tart-telescope/radio_module/README.md

# radio_module
Code for the TART-3 radio module (verilog for the FPGA, C for the microcontroller)
