tart-telescope/radio_module/hardware/README.md

# Hardware PCB designs and Schematics

This folder contains the schematics for the radio module of the TART radio telescope.

Author: Tim Molteno tim@elec.ac.nz
