tart-telescope/radio_module/hardware/papilio_sodimm_interposer/README.md

Relies on the github libraries for DDR3

https://github.com/ganioc/kicad-footprint/
