tart-telescope/radio_module/hardware/papilio_sodimm_interposer/spartan-6_papilio_sodimm.ods

Device/Package 6slx9tqg144 Wed Mar 31 17 | 26 | 10 2010
Pin | Bank | BUFIO2 | Pin Description | SODIMM 204 Pin | Papilio Pro + | Pin# Papilio Pro + | TART assignment
P144 | 0 | TL | IO_L1P_HSWAPEN_0 |  | GND | PWR
P143 | 0 | TL | IO_L1N_VREF_0 |  | BA0 | MEM
P142 | 0 | TL | IO_L2P_0 |  | BA1 | MEM
P141 | 0 | TL | IO_L2N_0 |  | A10 | MEM
P140 | 0 | TL | IO_L3P_0 |  | A0 | MEM
P139 | 0 | TL | IO_L3N_0 |  | A1 | MEM
P138 | 0 | TL | IO_L4P_0 |  | A2 | MEM
P137 | 0 | TL | IO_L4N_0 |  | A3 | MEM
P134 | 0 | TL | IO_L34P_GCLK19_0 | 90 | W2_A16 | C0 | DT_2_4
P133 | 0 | TL | IO_L34N_GCLK18_0 | 89 | W2_A15 | C1 | DT_1_4
P132 | 0 | TL | IO_L35P_GCLK17_0 | 95 | W2_A14 | C2 | DT_3_4
P131 | 0 | TL | IO_L35N_GCLK16_0 | 119 | W2_A13 | C3 | (CLK_OUT_4)
P127 | 0 | TR | IO_L36P_GCLK15_0 | 113 | W2_A12 | C4 | DT_6_4
P126 | 0 | TR | IO_L36N_GCLK14_0 | 101 | W2_A11 | C5 | DT_4_4
P124 | 0 | TR | IO_L37P_GCLK13_0 | 107 | W2_A10 | C6 | DT_5_4
P123 | 0 | TR | IO_L37N_GCLK12_0 |  | W2_A9 | C7 | NC
P121 | 0 | TR | IO_L62P_0 |  | W2_A8 | C8 | NC
P120 | 0 | TR | IO_L62N_VREF_0 | 51 | W2_A7 | C9 | DT_5_1
P119 | 0 | TR | IO_L63P_SCP7_0 | 47 | W2_A6 | C10 | DT_4_1
P118 | 0 | TR | IO_L63N_SCP6_0 | 50 | W2_A5 | C11 | DT_6_1
P117 | 0 | TR | IO_L64P_SCP5_0 | 41 | W2_A4 | C12 | DT_3_1
P116 | 0 | TR | IO_L64N_SCP4_0 | 29 | W2_A3 | C13 | DT_1_1
P115 | 0 | TR | IO_L65P_SCP3_0 | 35 | W2_A2 | C14 | DT_2_1
P114 | 0 | TR | IO_L65N_SCP2_0 | 125 | W2_A1 | C15 | (CLK_OUT_1)
P112 | 0 | TR | IO_L66P_SCP1_0 |  | LED1 | NA
P111 | 0 | TR | IO_L66N_SCP0_0 |  | NC | NA
P109 | NA | NA | TCK |  | TCK | NA
P110 | NA | NA | TDI |  | TDI | NA
P107 | NA | NA | TMS |  | TMS | NA
P106 | NA | NA | TDO |  | TDO | NA
P105 | 1 | RT | IO_L1P_1 |  | USB_RXD | NA
P104 | 1 | RT | IO_L1N_VREF_1 |  | NC | NC
P102 | 1 | RT | IO_L32P_1 |  | NC | NC
P101 | 1 | RT | IO_L32N_1 |  | USB_TXD | NA
P100 | 1 | RT | IO_L33P_1 |  | W1_A16 | A15 | NC
P99 | 1 | RT | IO_L33N_1 | 74 | W1_B1 | B0 | DT_2_3
P98 | 1 | RT | IO_L34P_1 |  | W1_A15 | A14 | NC
P97 | 1 | RT | IO_L34N_1 | 73 | W1_B2 | B1 | DT_1_3
P95 | 1 | RT | IO_L40P_GCLK11_1 | 67 | W1_B10 | B9 | DT_5_2
P94 | 1 | RT | IO_L40N_GCLK10_1 |  | OSC_IN | NA
P93 | 1 | RT | IO_L41P_GCLK9_IRDY1_1 |  | W1_A14 | A13 | NC
P92 | 1 | RT | IO_L41N_GCLK8_1 | 77 | W1_B3 | B2 | DT_3_3
P88 | 1 | RB | IO_L42P_GCLK7_1 |  | W1_A13 | A12 | NC
P87 | 1 | RB | IO_L42N_GCLK6_TRDY1_1 | 121 | W1_B4 | B3 | (CLK_OUT_3)
P85 | 1 | RB | IO_L43P_GCLK5_1 |  | W1_A12 | A11 | SCLK
P84 | 1 | RB | IO_L43N_GCLK4_1 | 84 | W1_B5 | B4 | DT_6_3
P83 | 1 | RB | IO_L45P_1 |  | W1_A11 | A10 | MOSI
P82 | 1 | RB | IO_L45N_1 | 78 | W1_B6 | B5 | DT_4_3
P81 | 1 | RB | IO_L46P_1 |  | W1_A10 | A9 | MISO
P80 | 1 | RB | IO_L46N_1 | 83 | W1_B7 | B6 | DT_5_3
P79 | 1 | RB | IO_L47P_1 |  | W1_A9 | A8 | CS0
P78 | 1 | RB | IO_L47N_1 | 123 | W1_B8 | B7 | (CLK_OUT_2)
P75 | 1 | RB | IO_L74P_AWAKE_1 |  | W1_A8 | A7 | NC
P74 | 1 | RB | IO_L74N_DOUT_BUSY_1 |  | W1_B9 | B8 | (START)
P73 | NA | NA | SUSPEND |  | GND | GND
P72 | 2 | NA | CMPCS_B_2 |  | NC | NC
P71 | 2 | NA | DONE_2 |  | NC | NC
P70 | 2 | BR | IO_L1P_CCLK_2 |  | FLASH_SCK | MEM
P69 | 2 | BR | IO_L1N_M0_CMPMISO_2 |  | +3V3 | +3V3
P67 | 2 | BR | IO_L2P_CMPCLK_2 |  | W1_A7 | A6 | NC
P66 | 2 | BR | IO_L2N_CMPMOSI_2 |  | W1_A6 | A5 | NC
P65 | 2 | BR | IO_L3P_D0_DIN_MISO_MISO1_2 |  | FLASH_SO | NA
P64 | 2 | BR | IO_L3N_MOSI_CSI_B_MISO0_2 |  | FLASH_SI | NA
P62 | 2 | BR | IO_L12P_D1_MISO2_2 | 62 | W1_B11 | B10 | DT_4_2
P61 | 2 | BR | IO_L12N_D2_MISO3_2 |  | W1_A5 | A4 | NC
P60 | 2 | BR | IO_L13P_M1_2 |  | GND | GND
P59 | 2 | BR | IO_L13N_D10_2 | 68 | W1_B12 | B11 | DT_6_2
P58 | 2 | BR | IO_L14P_D11_2 |  | W1_A4 | A3 | NC
P57 | 2 | BR | IO_L14N_D12_2 | 63 | W1_B13 | B12 | DT_3_2
P56 | 2 | BR | IO_L30P_GCLK1_D13_2 |  | W1_A3 | A2 | NC
P55 | 2 | BR | IO_L30N_GCLK0_USERCCLK_2 |  | W1_B14 | B13 | CLK_FPGA
P51 | 2 | BL | IO_L31P_GCLK31_D14_2 |  | W1_A2 | A1 | NC
P50 | 2 | BL | IO_L31N_GCLK30_D15_2 | 57 | W1_B15 | B14 | DT_1_2
P48 | 2 | BL | IO_L48P_D7_2 |  | W1_A1 | A0 | NC
P47 | 2 | BL | IO_L48N_RDWR_B_VREF_2 | 58 | W1_B16 | B15 | DT_2_2
P46 | 2 | BL | IO_L49P_D3_2 |  | A4 | MEM
P45 | 2 | BL | IO_L49N_D4_2 |  | A5 | MEM
P44 | 2 | BL | IO_L62P_D5_2 |  | A6 | MEM
P43 | 2 | BL | IO_L62N_D6_2 |  | A7 | MEM
P41 | 2 | BL | IO_L64P_D8_2 |  | A8 | MEM
P40 | 2 | BL | IO_L64N_D9_2 |  | A9 | MEM
P39 | 2 | BL | IO_L65P_INIT_B_2 |  | NC | NC
P38 | 2 | BL | IO_L65N_CSO_B_2 |  | FLASH_CS | MEM
P37 | 2 | NA | PROGRAM_B_2 |  | REBOOT | NC
P35 | 3 | LB | IO_L1P_3 |  | A11 | MEM
P34 | 3 | LB | IO_L1N_VREF_3 |  | A12 | MEM
P33 | 3 | LB | IO_L2P_3 |  | CKE | MEM
P32 | 3 | LB | IO_L2N_3 |  | CLK | MEM
P30 | 3 | LB | IO_L36P_3 |  | DQ15 | MEM
P29 | 3 | LB | IO_L36N_3 |  | DQ14 | MEM
P27 | 3 | LB | IO_L37P_3 |  | DQ13 | MEM
P26 | 3 | LB | IO_L37N_3 |  | DQ12 | MEM
P24 | 3 | LB | IO_L41P_GCLK27_3 |  | DQ11 | MEM
P23 | 3 | LB | IO_L41N_GCLK26_3 |  | DQ10 | MEM
P22 | 3 | LB | IO_L42P_GCLK25_TRDY2_3 |  | DQ9 | MEM
P21 | 3 | LB | IO_L42N_GCLK24_3 |  | DQ8 | MEM
P17 | 3 | LT | IO_L43P_GCLK23_3 |  | DQMH | MEM
P16 | 3 | LT | IO_L43N_GCLK22_IRDY2_3 |  | DQ6 | MEM
P15 | 3 | LT | IO_L44P_GCLK21_3 |  | DQ5 | MEM
P14 | 3 | LT | IO_L44N_GCLK20_3 |  | DQ4 | MEM
P12 | 3 | LT | IO_L49P_3 |  | DQ3 | MEM
P11 | 3 | LT | IO_L49N_3 |  | DQ2 | MEM
P10 | 3 | LT | IO_L50P_3 |  | DQ1 | MEM
P9 | 3 | LT | IO_L50N_3 |  | DQ0 | MEM
P8 | 3 | LT | IO_L51P_3 |  | DQ7 | MEM
P7 | 3 | LT | IO_L51N_3 |  | DQML | MEM
P6 | 3 | LT | IO_L52P_3 |  | !WE | MEM
P5 | 3 | LT | IO_L52N_3 |  | !CAS | MEM
P2 | 3 | LT | IO_L83P_3 |  | !RAS | MEM
P1 | 3 | LT | IO_L83N_VREF_3 |  | CS | MEM
P108 | NA | NA | GND |  | GND | GND
P113 | NA | NA | GND |  | GND | GND
P13 | NA | NA | GND |  | GND | GND
P130 | NA | NA | GND |  | GND | GND
P136 | NA | NA | GND |  | GND | GND
P25 | NA | NA | GND |  | GND | GND
P3 | NA | NA | GND |  | GND | GND
P49 | NA | NA | GND |  | GND | GND
P54 | NA | NA | GND |  | GND | GND
P68 | NA | NA | GND |  | GND | GND
P77 | NA | NA | GND |  | GND | GND
P91 | NA | NA | GND |  | GND | GND
P96 | NA | NA | GND |  | GND | GND
P129 | NA | NA | VCCAUX |  | +3V3 | +3V3
P20 | NA | NA | VCCAUX |  | +3V3 | +3V3
P36 | NA | NA | VCCAUX |  | +3V3 | +3V3
P53 | NA | NA | VCCAUX |  | +3V3 | +3V3
P90 | NA | NA | VCCAUX |  | +3V3 | +3V3
P128 | NA | NA | VCCINT |  | +1V2 | +1V2
P19 | NA | NA | VCCINT |  | +1V2 | +1V2
P28 | NA | NA | VCCINT |  | +1V2 | +1V2
P52 | NA | NA | VCCINT |  | +1V2 | +1V2
P89 | NA | NA | VCCINT |  | +1V2 | +1V2
P122 | 0 | NA | VCCO_0 |  | +3V3 | +3V3
P125 | 0 | NA | VCCO_0 |  | +3V3 | +3V3
P135 | 0 | NA | VCCO_0 |  | +3V3 | +3V3
P103 | 1 | NA | VCCO_1 |  | +3V3 | +3V3
P76 | 1 | NA | VCCO_1 |  | +3V3 | +3V3
P86 | 1 | NA | VCCO_1 |  | +3V3 | +3V3
P42 | 2 | NA | VCCO_2 |  | +3V3 | +3V3
P63 | 2 | NA | VCCO_2 |  | +3V3 | +3V3
P18 | 3 | NA | VCCO_3 |  | +3V3 | +3V3
P31 | 3 | NA | VCCO_3 |  | +3V3 | +3V3
P4 | 3 | NA | VCCO_3 |  | +3V3 | +3V3
Total Number of Pins generated | 144
