tart-telescope/radio_module/(threads)

Thread 2 (2023-03-07):

Swap SPI pints for comms to radios

tmolteno, 2023-03-07:
Put each radio on one of the avr4809 SPI interfaces. See [here](https://github.com/MCUdude/MegaCoreX/blob/master/Extended-API.md#peripheral-pin-swapping) for which ones.

Suggest.
* Radio A: 4,5,6,7
* Radio B: 14,15,16,17

tmolteno, 2023-04-30:
Closing as updated hardware not affected

Closed 2023-04-30.

Thread 4 (2023-04-30):

Radio Board Updates

tmolteno, 2023-04-30:
- [ ] Enable the RX driver for the clock.

tmolteno, 2023-05-08:
Look into the ground planes...

If you have separated ground planes make sure no trace crosses the gab between them. Otherwise you just build a slot antenna.

If you must have separated ground and need to cross over it with a trace make you need to provide a direct path for the return current. This is done by placing a capacitor that connects your two ground planes as near as possible to the trace.  A 1 nF ceramic will do.

tmolteno, 2023-08-16:
Minor update: Reorder radios on the boards.

Thread 5 (2023-04-30):

Motherboard Changes for 3.0

tmolteno, 2023-04-30:
- [x] Change GPIO to use non-altfunction pins
- [x] Add RPI Header
- [x] Add Tang Primer 20k
- [x] Use the EN (enable) line on the radios to be controlled by the MCU.
- [ ] Add a power enable to the radio power supply from the MCU.
- [x] Check clock oscillator circuit (seems to require a capacitor from XTAL output to GND).
- [x] Move to Standard DDR3 connector for the FPGA

Tests

- [ ] Clock working on board.
- [x] Clock to radios.
- [ ]  Preconfigured device states. Pins to radios work.
- [ ] DSP modes.
- [ ] Check whether 3.3V should be sent to the FPGA?

Closed 2023-07-08.

Thread 6 (2023-04-30):

Dev Board 1.0 Changes

tmolteno, 2023-04-30:
Changes for the final dev board.

- [x] Add second radio
- [x] Add Ground Test Point.
- [x] Add clock comparator
- [x] Better MCU programming connector. Perhaps PH2.0?
- [x] Get Serial configuration timing according to typical timings on the MAX2769  data sheet. t_hi = 25.

tmolteno, 2023-05-17:
After testing a new revisions is needed. This will be addressed in a separate issue.

Closed 2023-05-17.

Thread 7 (2023-05-17):

Dev Board v1.0.0a2

tmolteno, 2023-05-17:
- [x] New high speed comparator.
- [x] PH2.0 connector for programming
- [ ] Control the power of the radios to provide a clean power down.
- [x] Move to new radio module.

tmolteno, 2023-06-04:
Closing because v3.0.0a is now being tested.

Closed 2023-06-04.

Thread 8 (2023-07-08):

Motherboard Changes for 3.0.0b1

tmolteno, 2023-07-08:
## Changes

- [x] GNDPWR connect to GND
- [x] + sign on power supply, and some voltage documentation in silkscreen.
- [x] A GPIO connection between the FPGA and the CPU. Allows the CPU to reset the radios if something goes wrong.
- [x] 32 Radios
- [x] 1A slow blow fuse on power supply
- [x] Board and Hole layout for 200x288 waterproof box Spelsberg TG-PC 2516-12

## Checks:

- [x] RPI power supply
- [x] Clock working
- [x] FPGA pins (use schematic for one of the tang primer 20k motherboards from sipeed.
- [ ] Correlate two radios and measure crosstalk between radios.
- [x] New power supply lower limit: 6.5V DC
- [x] Power supply upper limit: >30V DC (that is as far as I checked).

tmolteno, 2023-07-08:
The FPGA is not completely working. Need to figure out which pins are causing problems... They are on slot 1 as signal lines don't change when the FPGA is connected.

Closed 2023-08-16.

Thread 9 (2023-08-16):

Motherboard Changes

tmolteno, 2023-08-16:
Changes for the 32 antenna motherboard:

- [ ] Add a few thousand uF of capacitance on the power supply input to increase resilience against spikes. Perhaps isolate the ground with an inductor too?

Thread 10 (2024-03-28):

Clock buffer rework on both motherboard and radio board

tmolteno, 2024-03-28:
Add an 1:8 clock buffer LMK1C1106PWR to the motherboard clock distribution, and keep it single ended.

Add an 1:4 clock buffer LMK1C1102PWR or 74AVC9112 to the radio board.

Closed 2024-08-08.
