tart-telescope/radio_module/doc/dev_board.pdf

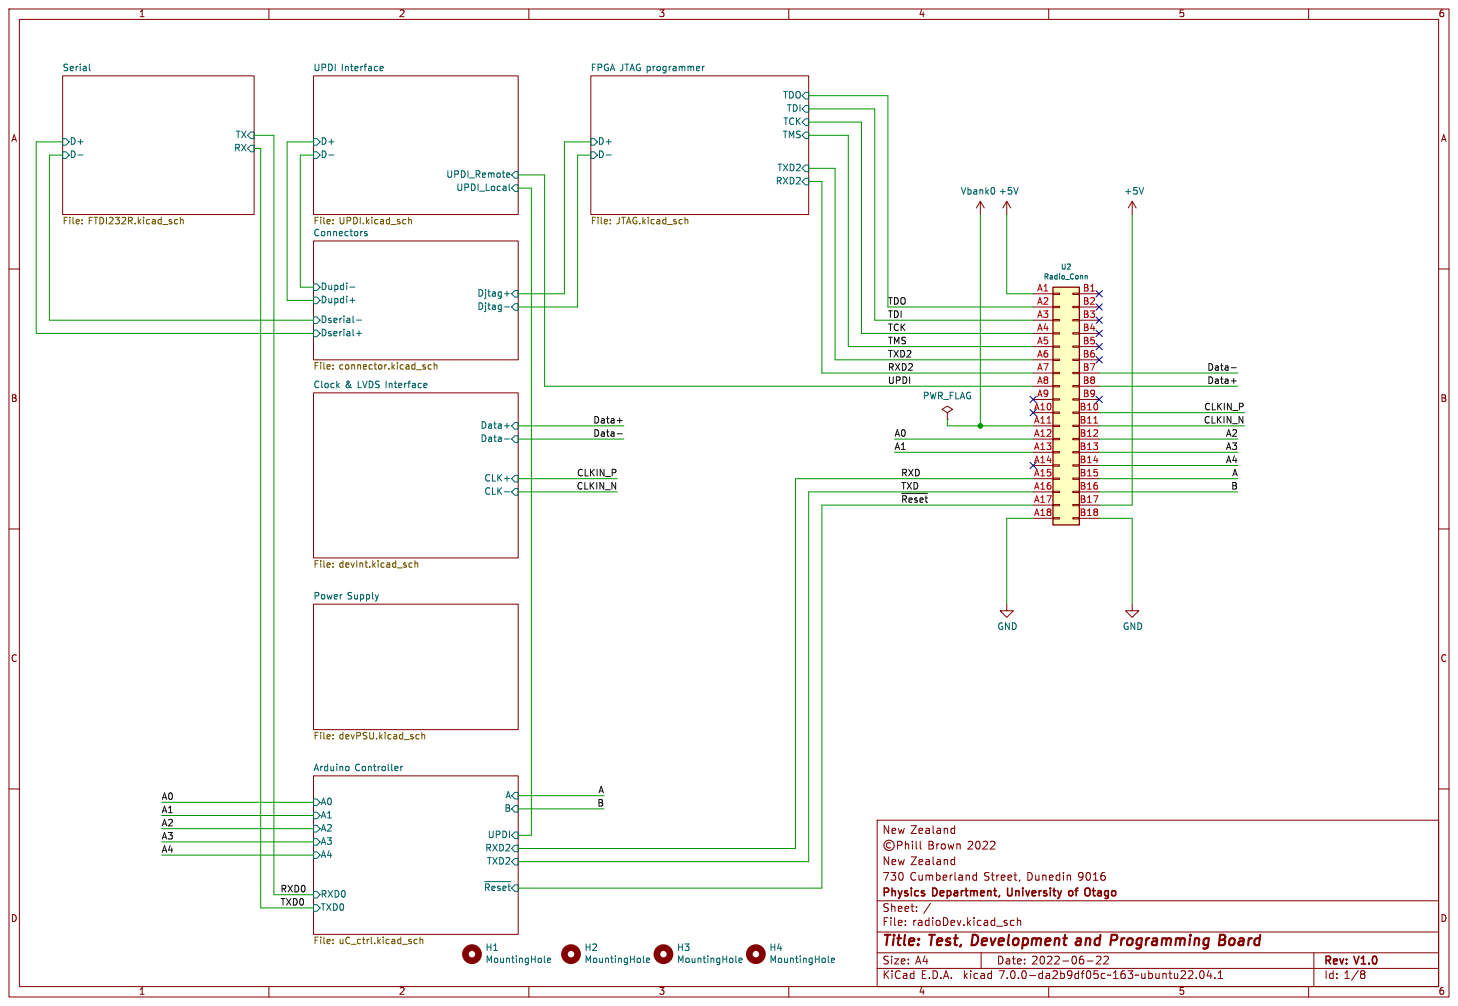
[picture p1: page 1]

A UPDI RXD2 TXD2 ~{Reset} TXD0 RXD0 Arduino Controller File: uC_ctrl.kicad_sch

þÿ©Phill Brown 2022 New Zealand

Id: 1/8 Title: Test, Development and Programming Board

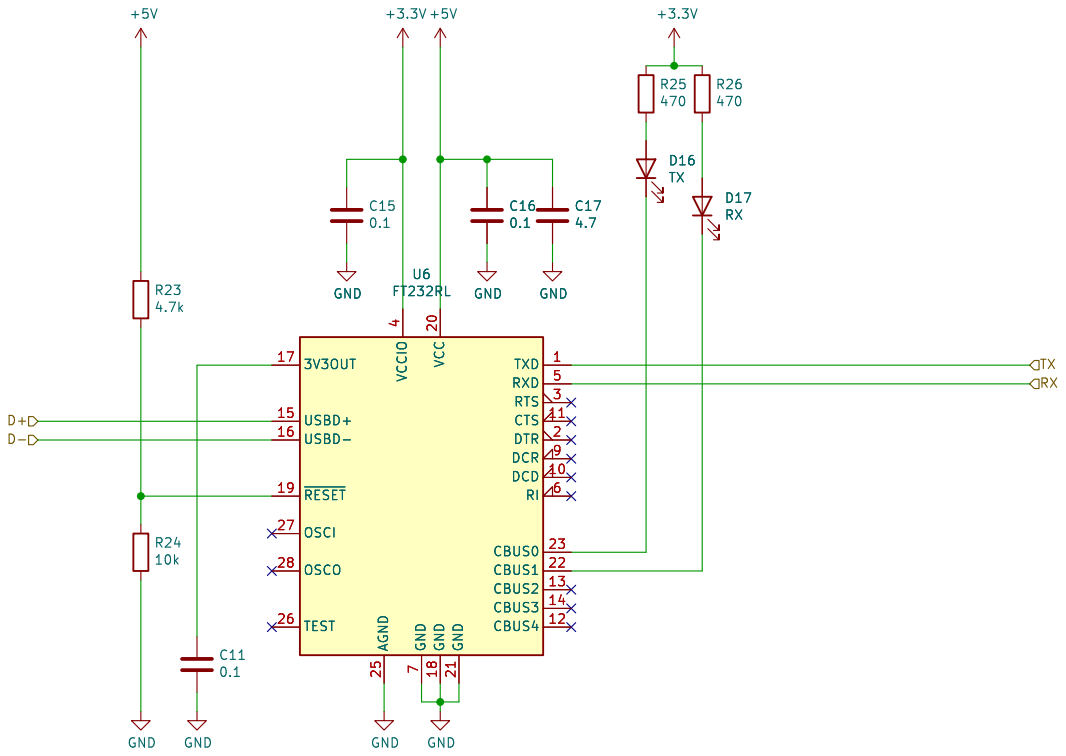
[picture p2: page 2]

7 DCR 9 U6 GND FT232RL +3.3V +5V GND GND

þÿ©Phill Brown 2022 New Zealand

Id: 2/8 Title: RS485 to Serial Interface

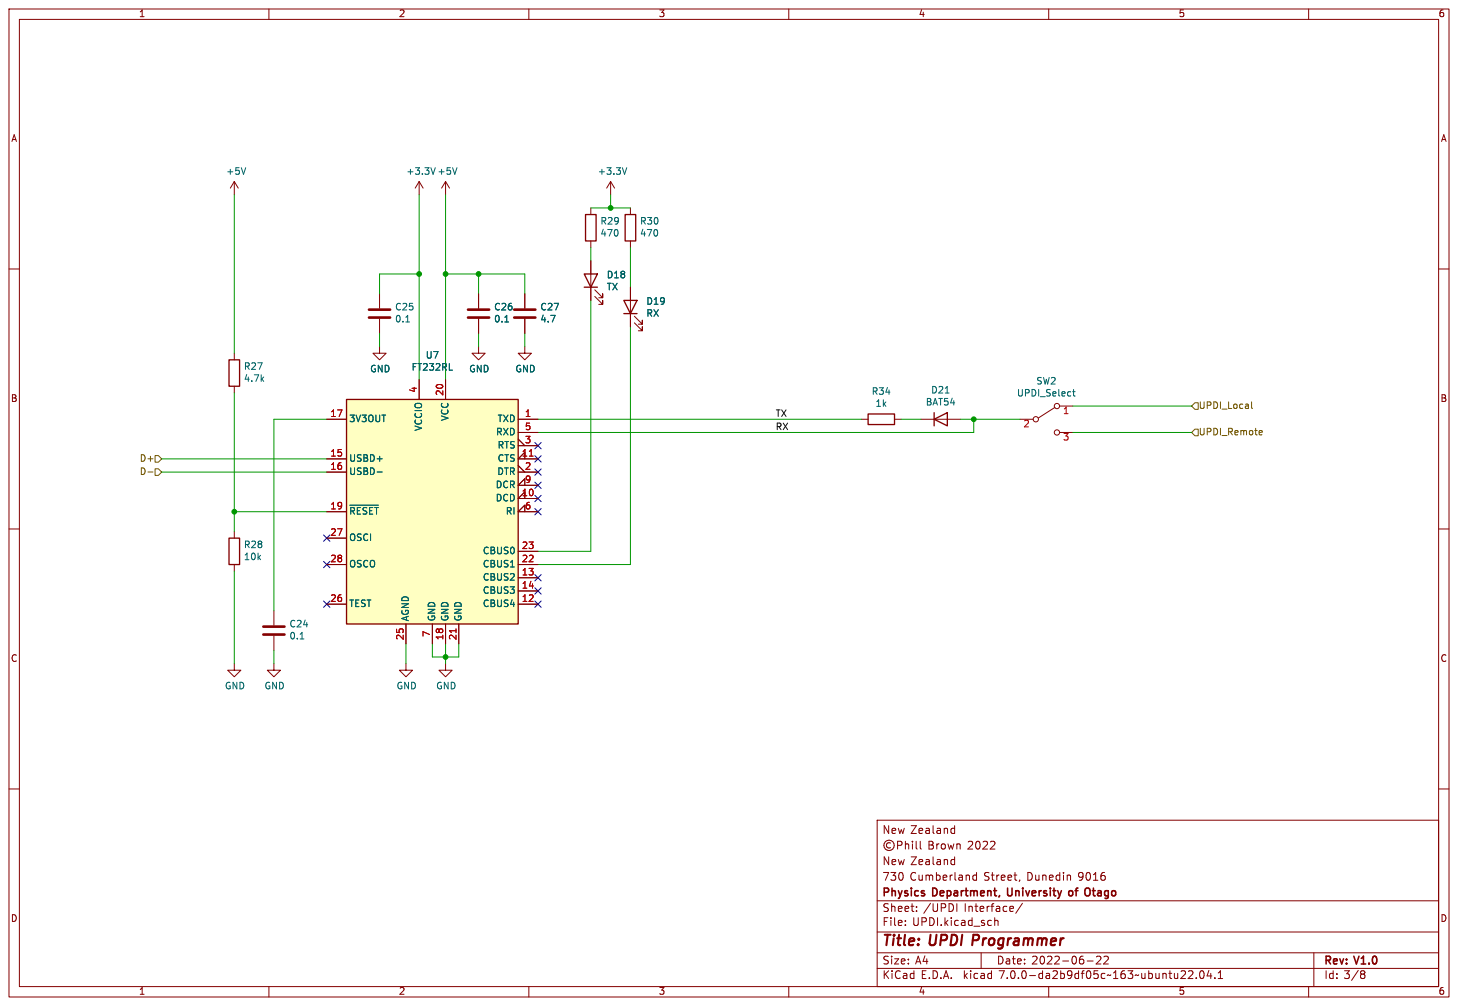
[picture p3: page 3]

þÿ©Phill Brown 2022 New Zealand GND

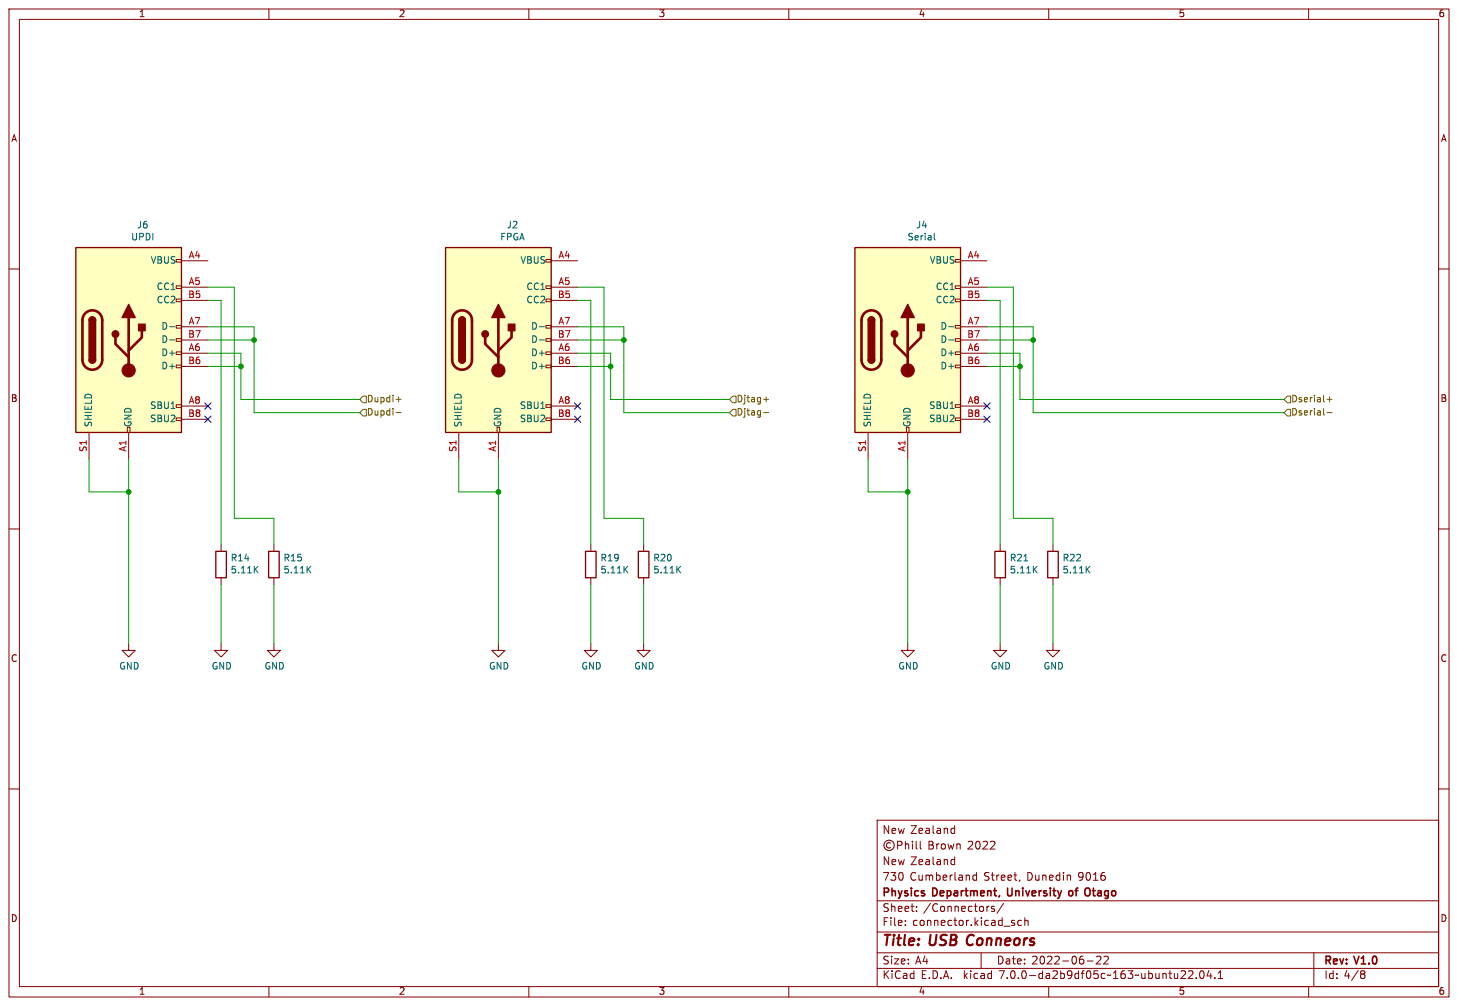
[picture p4: page 4]

Id: 4/8 Title: USB Conneors

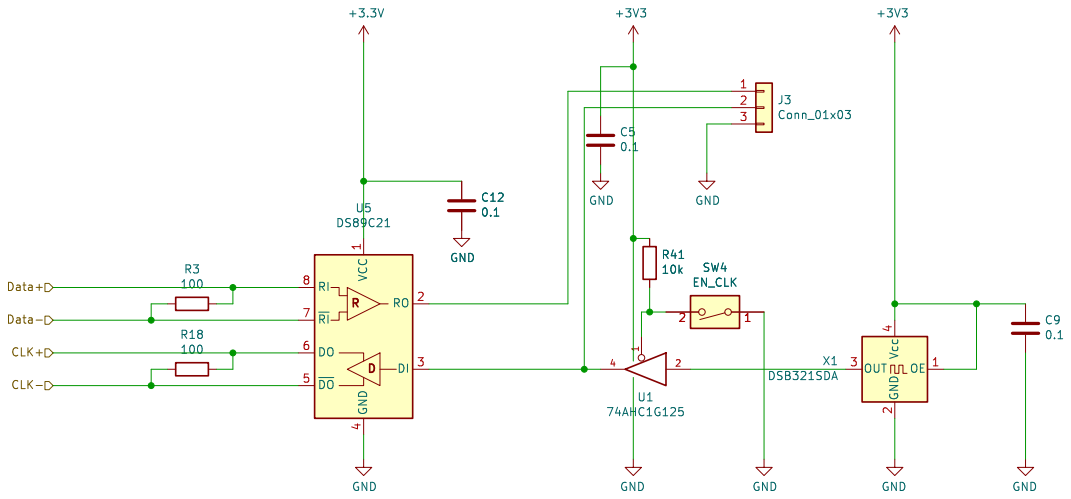
[picture p5: page 5]

þÿ©Phill Brown 2022 New Zealand

Id: 5/8 Title: Clock and LVDS Data interface

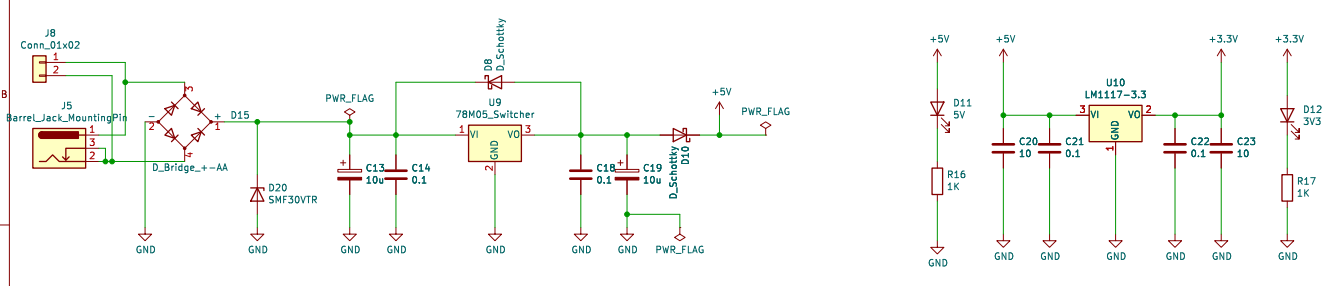
[picture p6: page 6]

þÿ©Phill Brown 2022 New Zealand D11

File: devPSU.kicad_sch Sheet: /Power Supply/
Id: 6/8 Title: Main Power Supply

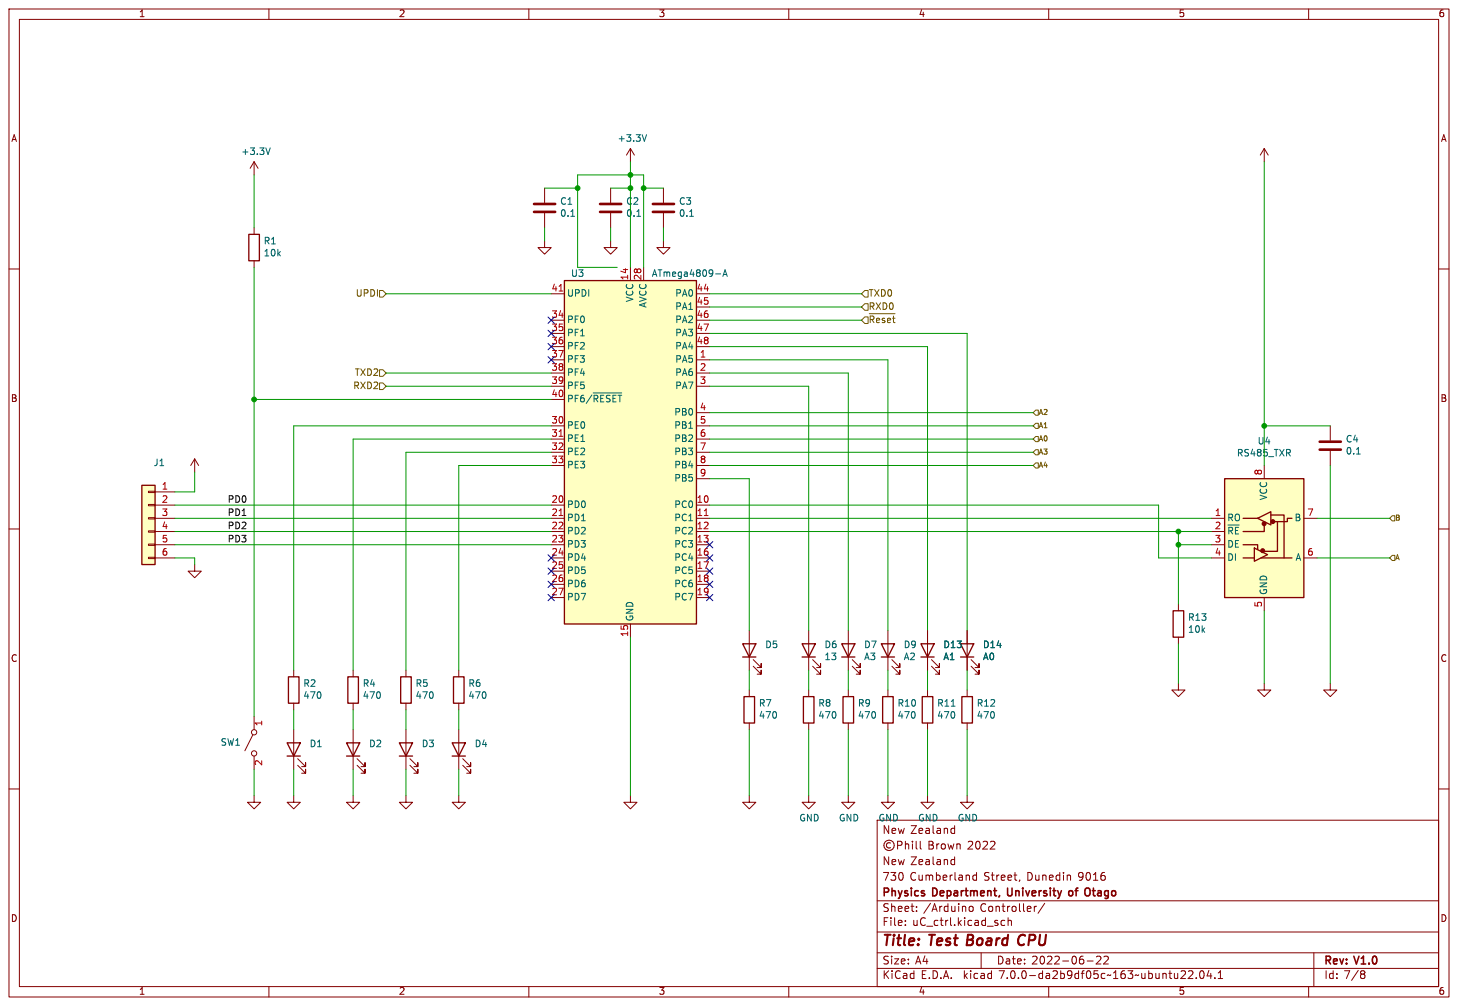
[picture p7: page 7]

þÿ©Phill Brown 2022 New Zealand R5

Id: 7/8 Title: Test Board CPU

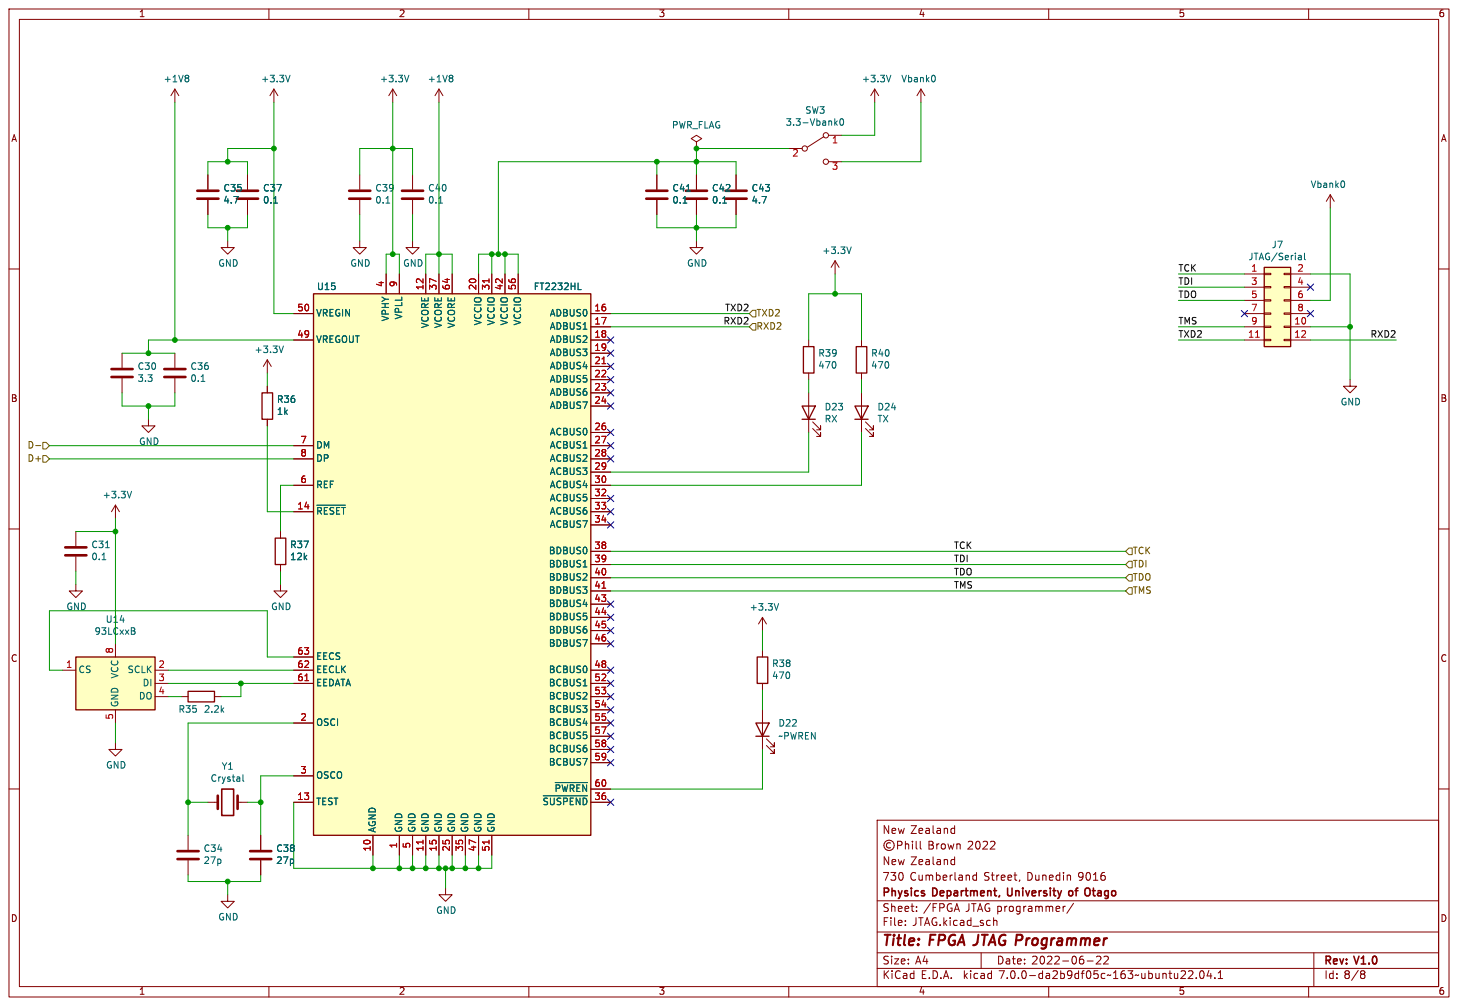
[picture p8: page 8]

1 AGND 10 GND 11 VCORE 12 TEST 13 ~{RESET} 14 GND 15 ADBUS0 16 ADBUS1 17 ADBUS2 18 ADBUS3 19 OSCI 2 VCCIO 20 ADBUS4 21 ADBUS5 22 ADBUS6 23 ADBUS7 24 GND 25 ACBUS0 26 ACBUS1 27 ACBUS2 28 ACBUS3 29 OSCO 3 ACBUS4 30 VCCIO 31 ACBUS5 32 ACBUS6 33 ACBUS7 34 GND 35
1k GND

4 BDBUS2 40 BDBUS3 41 VCCIO 42 BDBUS4 43 BDBUS5 44 BDBUS6 45 BDBUS7 46 GND 47 BCBUS0 48 VREGOUT 49 GND

5 VREGIN 50 GND 51 BCBUS1 52 BCBUS2 53 BCBUS3 54 BCBUS4 55 VCCIO 56 BCBUS5 57 BCBUS6 58 BCBUS7 59 REF 6 ~{PWREN}60 EEDATA 61 EECLK 62 EECS 63 VCORE 64 DM 7 DP 8 VPLL

þÿ©Phill Brown 2022 New Zealand

Id: 8/8 Title: FPGA JTAG Programmer File: JTAG.kicad_sch Sheet: /FPGA JTAG programmer/
