tart-telescope/radio_module/doc/radio_module.pdf

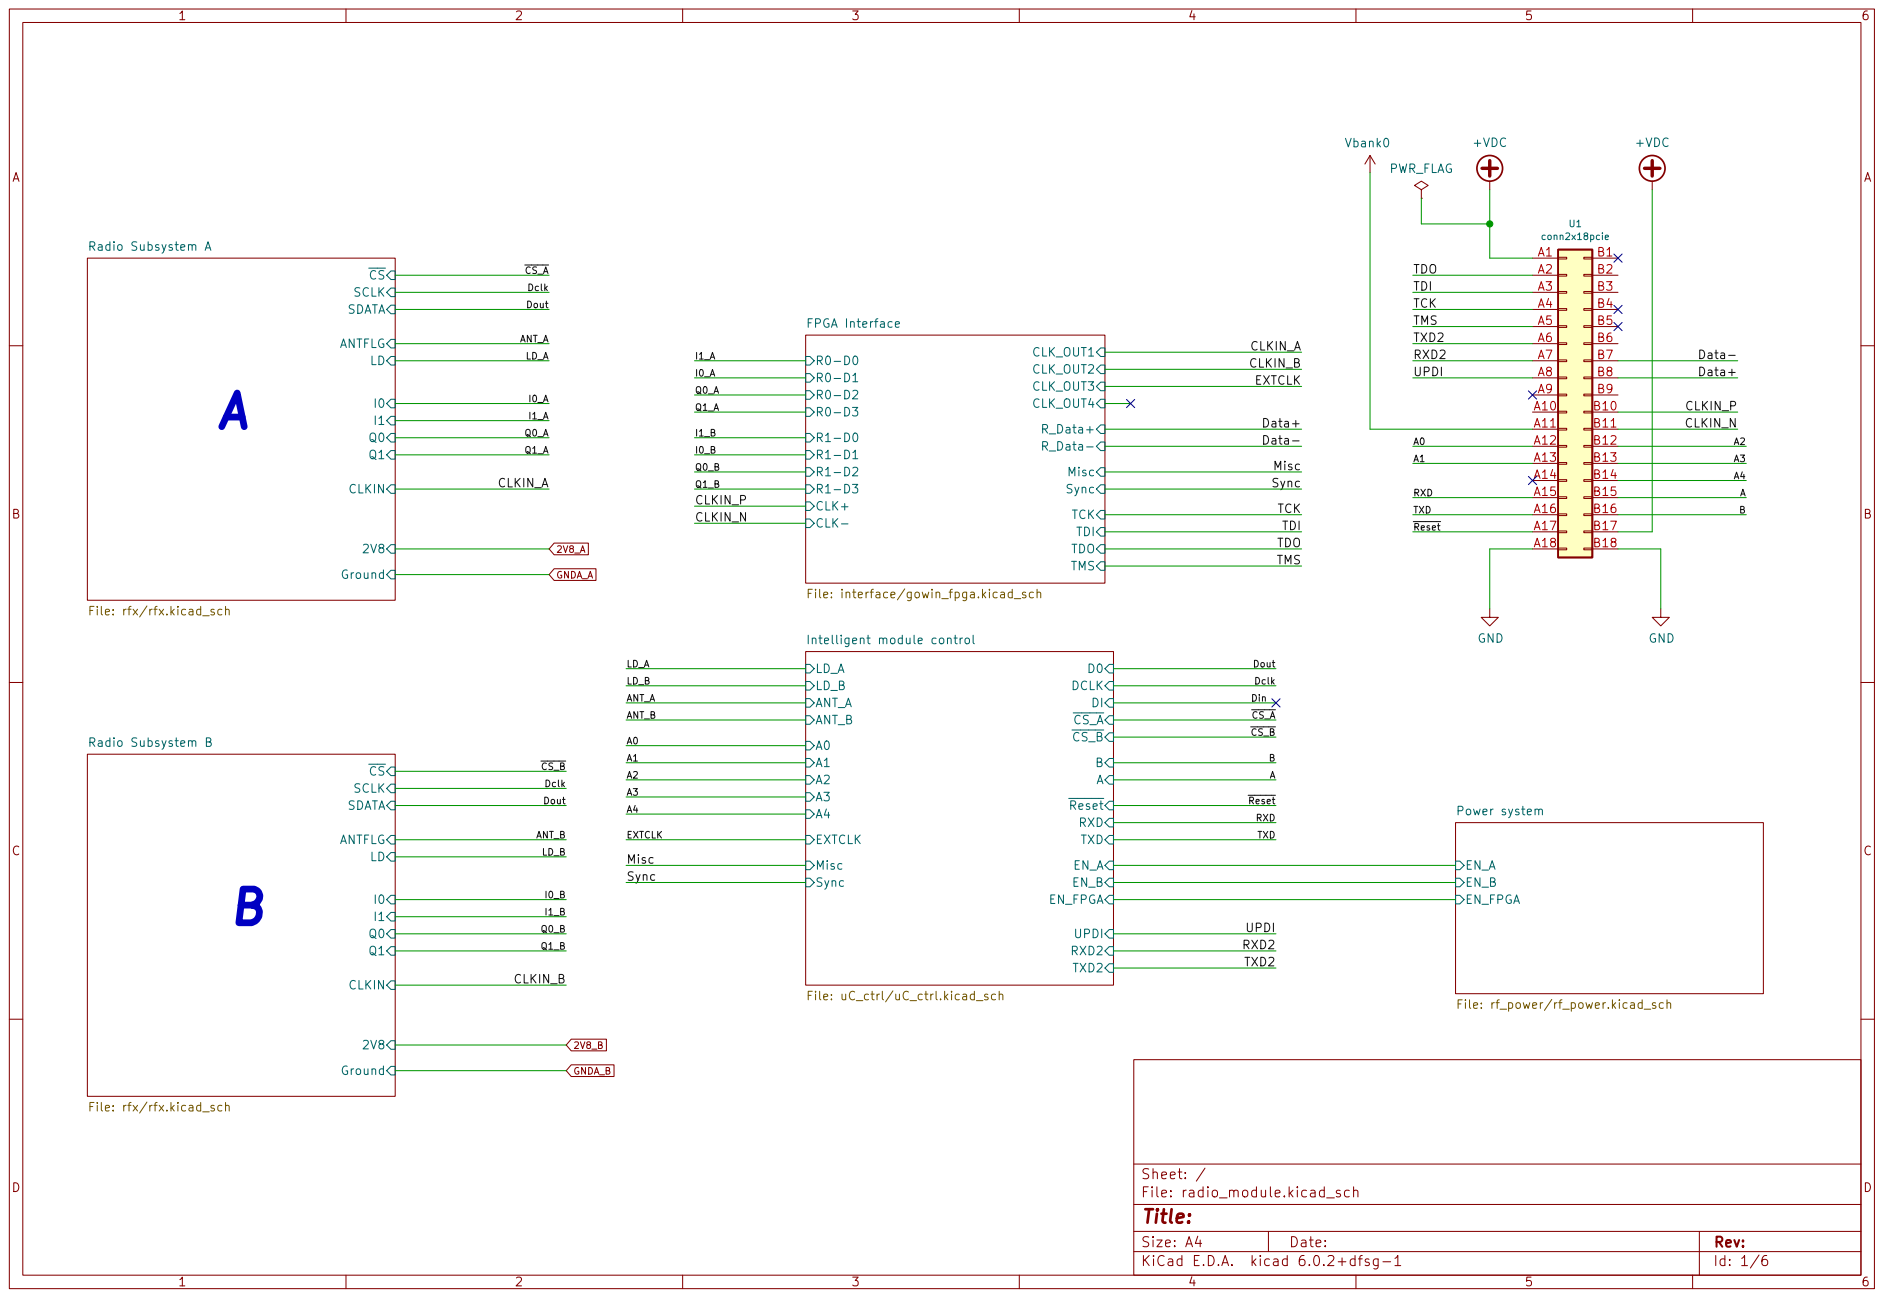
[picture p9: page 1]

A0TXD TDI TCK Misc EXTCLK Sync ANT_B

File: radio_module.kicad_sch Sheet: / ~{CS} SCLK

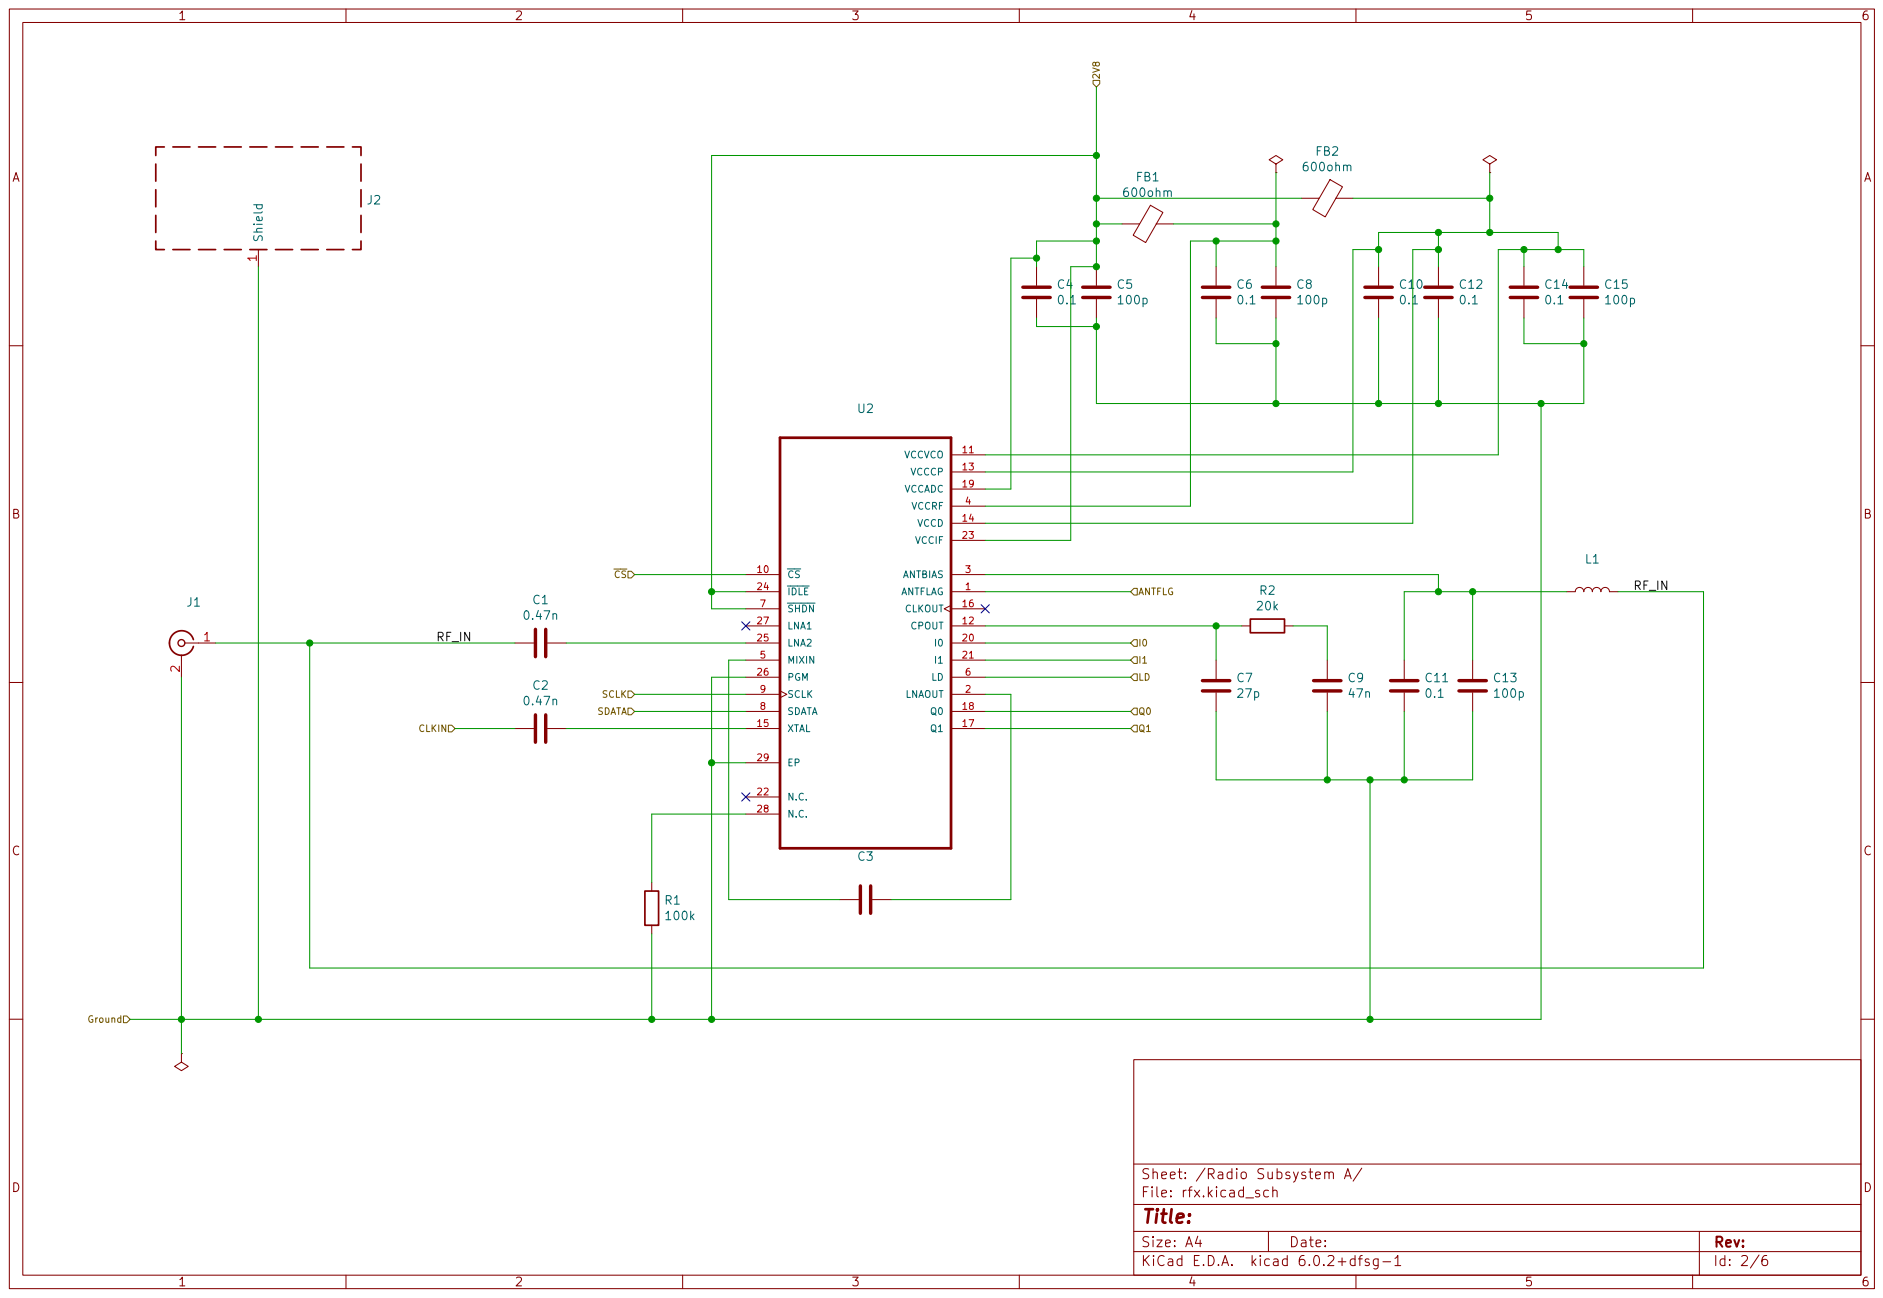
[picture p10: page 2]

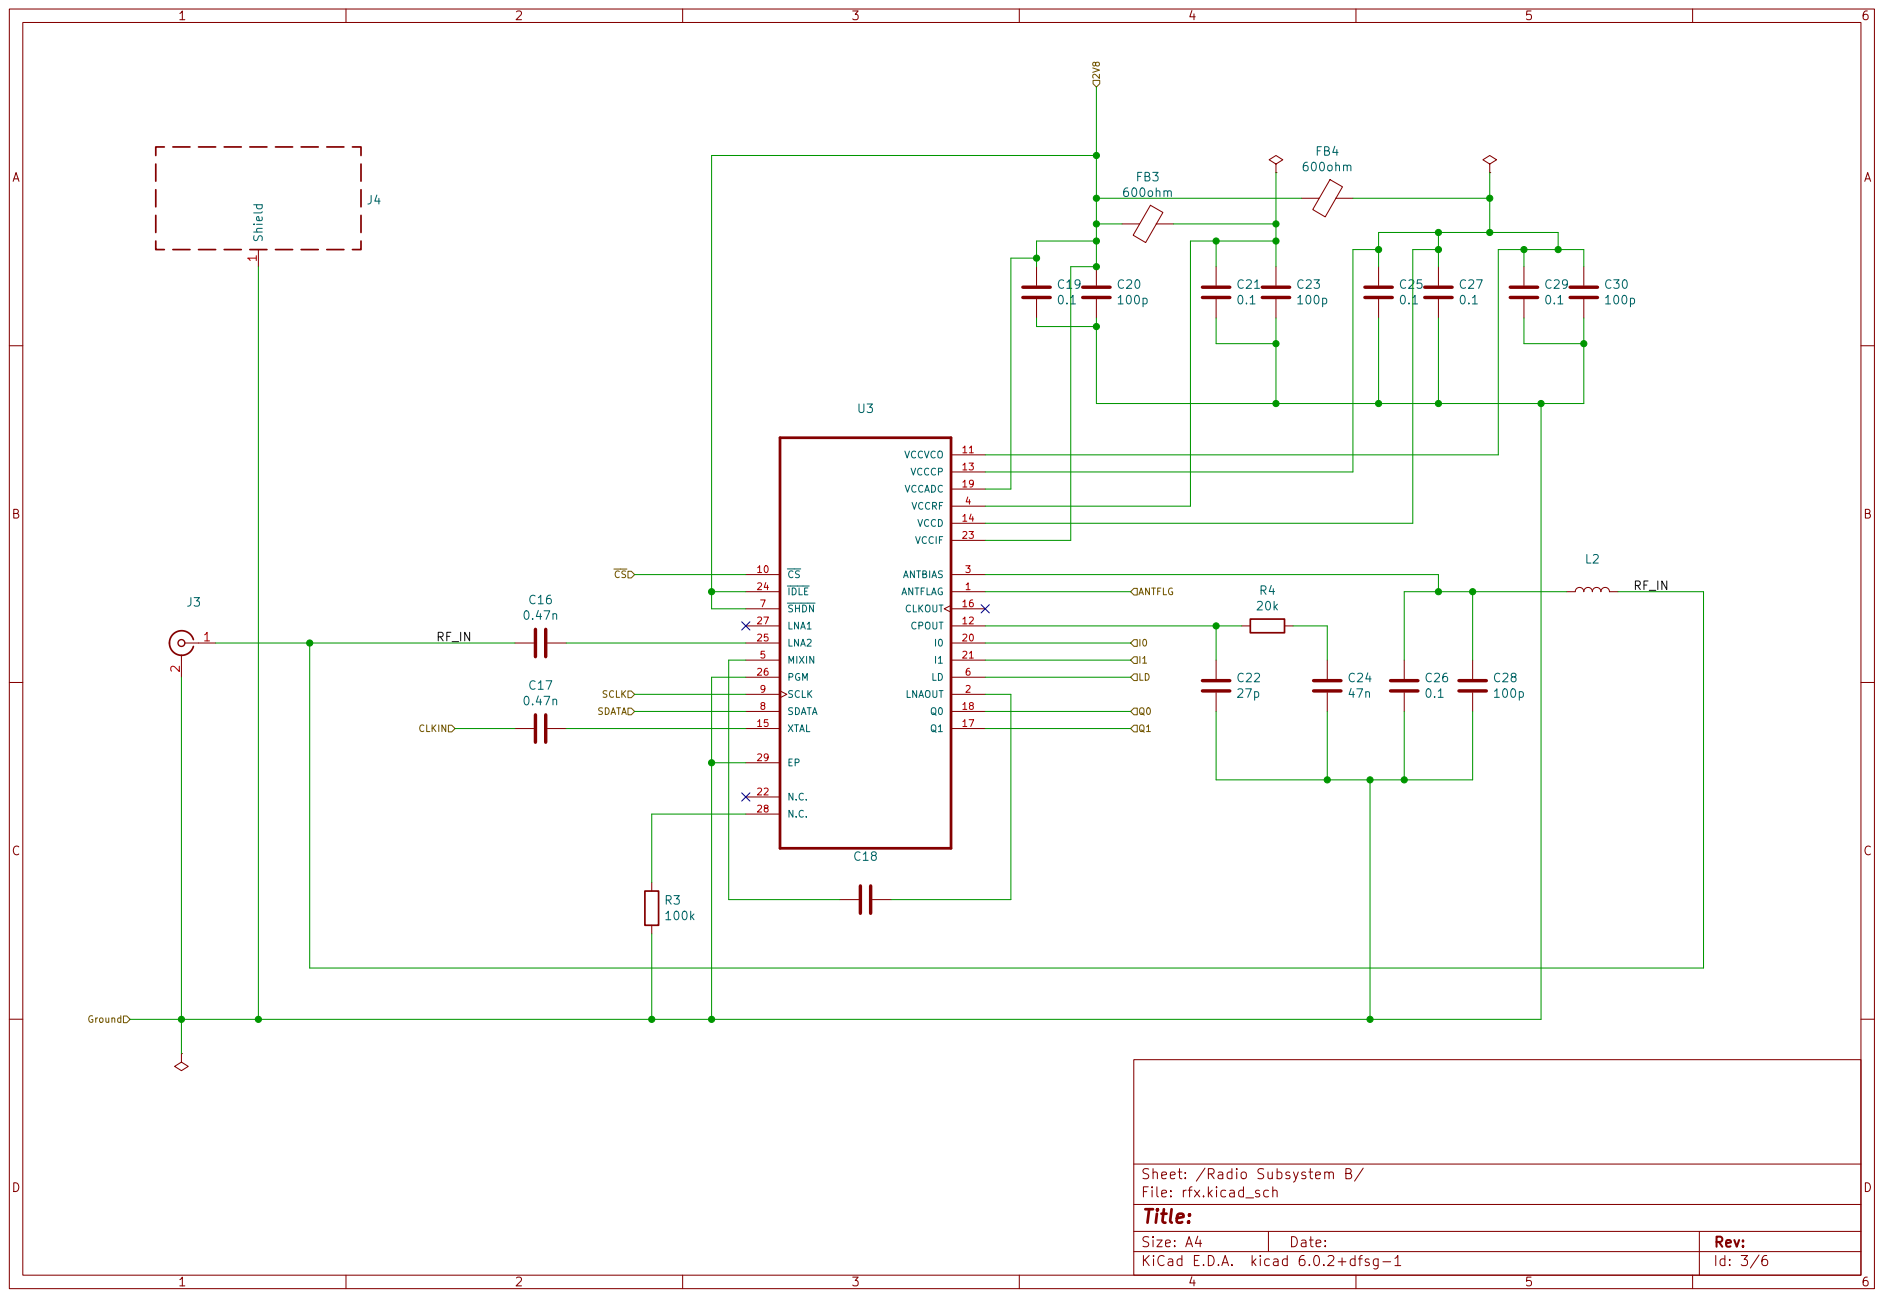
[picture p11: page 3]

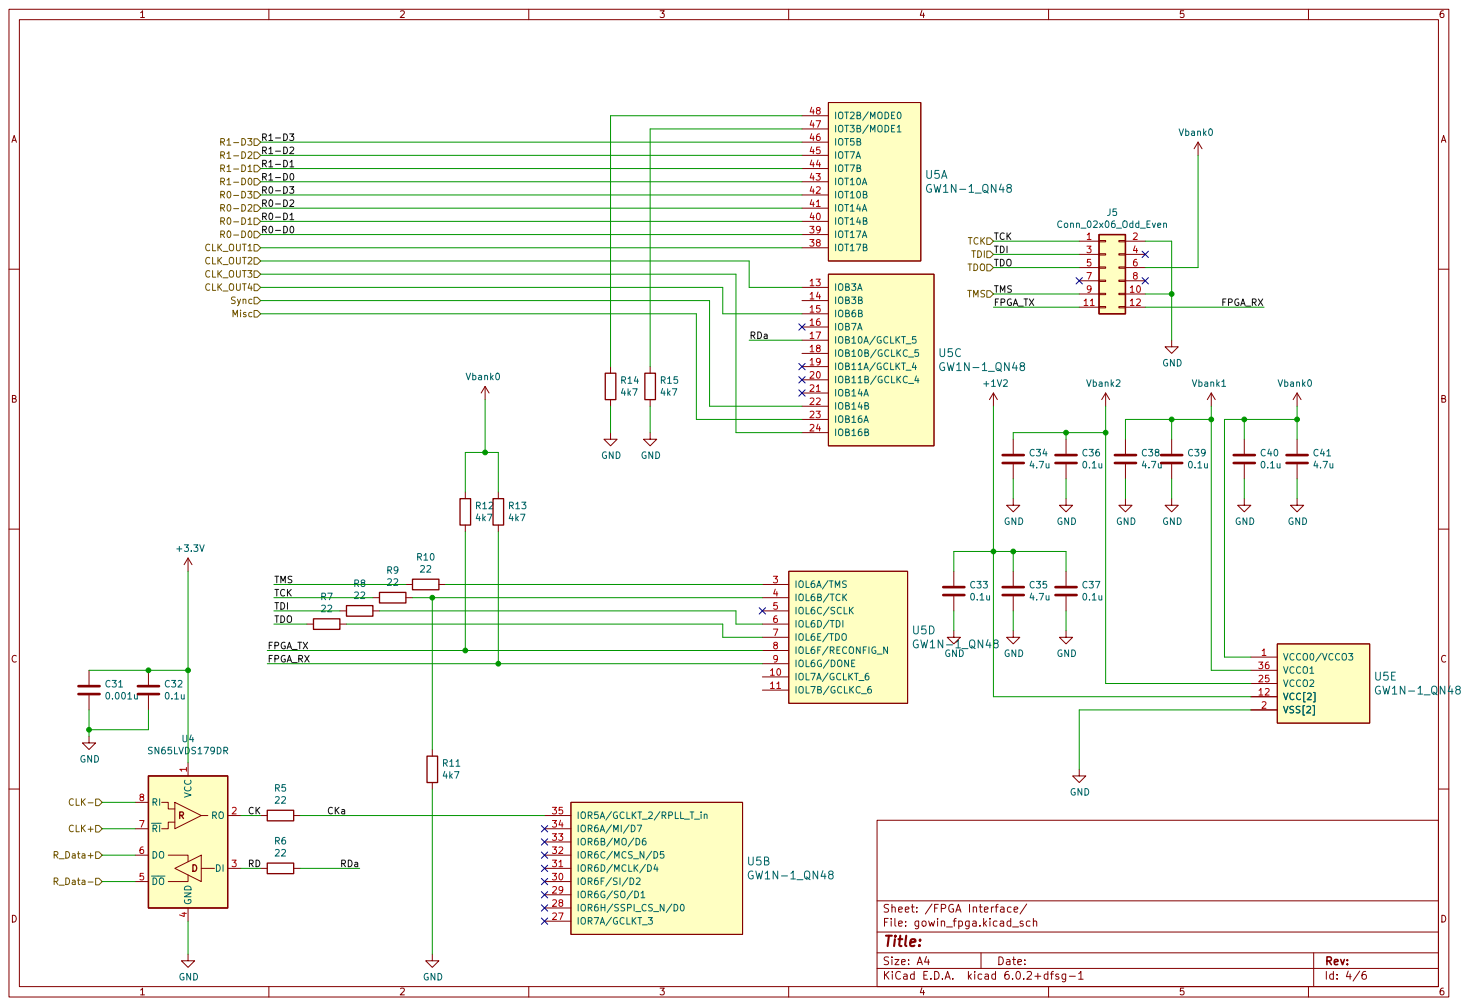
[picture p12: page 4]

4 ~{DO} 5 DO 6 ~{RI} 7 RI 8 U4 SN65LVDS179DR GND

File: gowin_fpga.kicad_sch Sheet: /FPGA Interface/
Id: 4/6 Title:

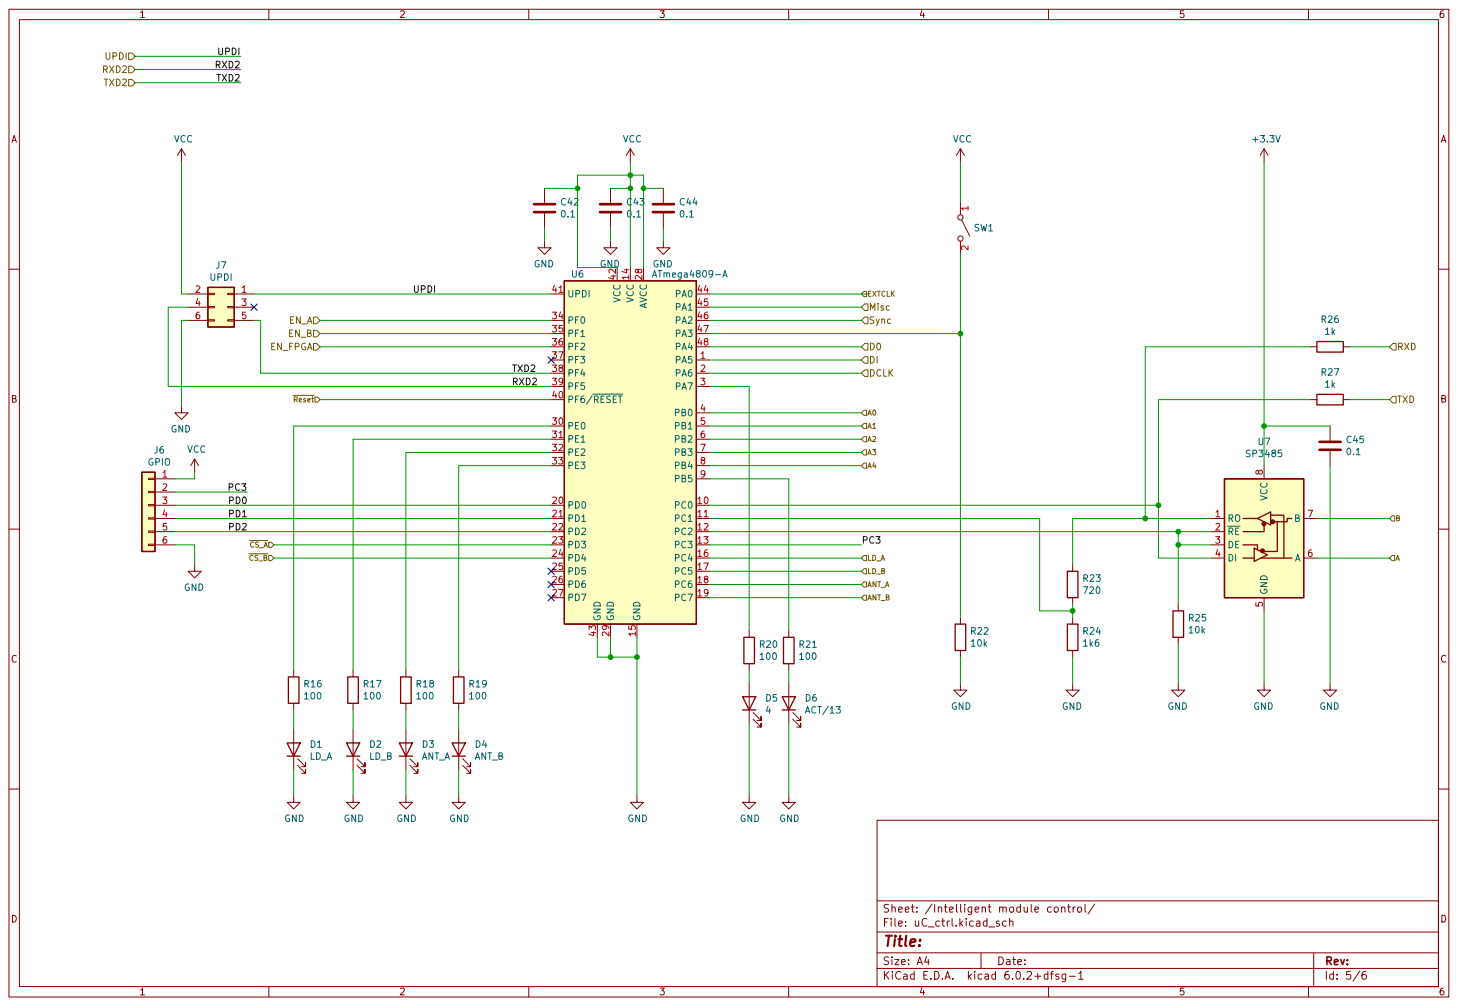
[picture p13: page 5]

Sheet: /Intelligent module control/ D2

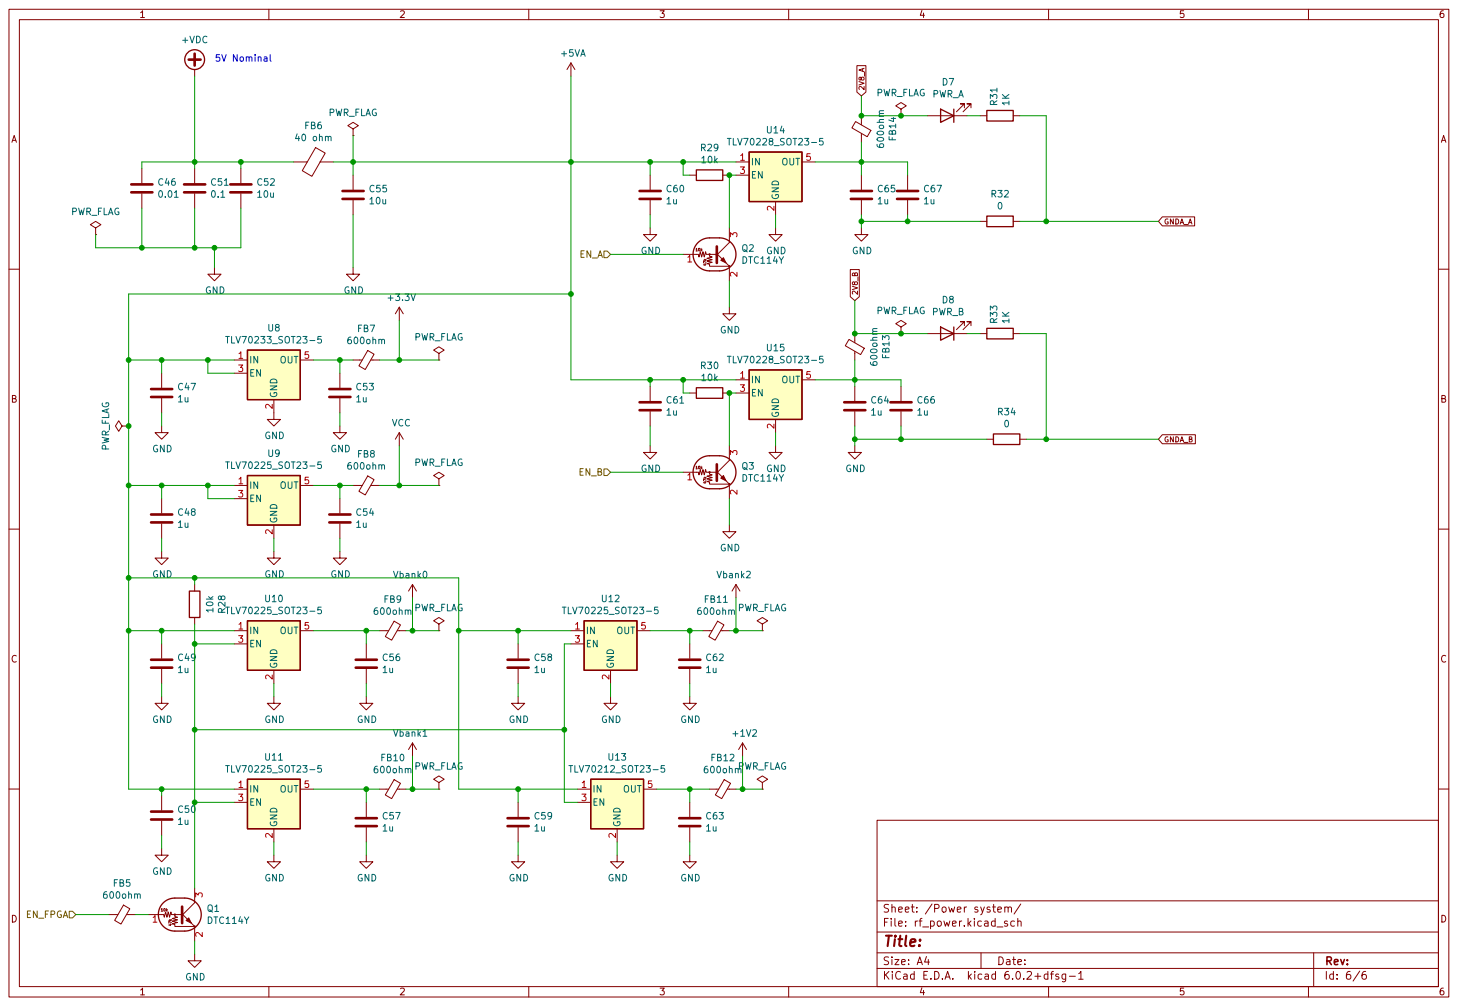
[picture p14: page 6]
