tart-telescope/radio_module/hardware/motherboard/tart_radio_config/src/max2769.h

// Max2769_handler
#include "hardware.h"

void setupRadio(GPIO_TypeDef* cs_port, pin_t cs_pin);
void setupRadioStream(GPIO_TypeDef *cs_port, pin_t cs_pin);

void shutdownRadio(void);
void enableRadio(void);
