tart-telescope/radio_module/(commit log)

2022-09-21 Added schematic
2022-09-29 Update data names and first pin assignments
2022-10-05 Update the pin locations
2023-02-21 Added dev board PDF layout
2023-03-07 Added some software SPI code
2023-03-15 Move to new pin numbering
2023-03-17 Update to use correct enabling
    [main.cpp]
2023-03-20 Add some MAX2769 SPI writing
2023-03-21 Flash the FPGA. Blink status LEDs
2023-03-22 Update the PLL conf. Fix missing field
    [max2769.cpp, radio_module.v]
2023-03-22 Get SPI going
2023-04-12 Basic test board nearly going
    [design.kicad_pcb, design.kicad_sch]
2023-04-13 Finish wiring up the Max2769. Clean up the PCIe symbol
    [design.kicad_pcb, design.kicad_sch]
2023-04-13 First draft of the boards are ready
    [baseboard.kicad_pcb, baseboard.kicad_sch, design.kicad_pcb, design.kicad_sch]
2023-04-13 Add LEDs to radio module, correct resistor components
    [baseboard.kicad_pcb, baseboard.kicad_sch, design.kicad_pcb, design.kicad_sch]
2023-04-13 Moved boards to a subdirectory
    [baseboard.kicad_pcb, baseboard.kicad_sch, design.kicad_pcb, design.kicad_sch]
2023-04-15 Added basic motherboard with Tang Primer 20k
    [Tang_Primer_20K_Footprint.kicad_sch, baseboard.kicad_pcb, baseboard.kicad_sch, motherboard.kicad_pcb, motherboard.kicad_sch, power.kicad_sch]
2023-04-21 Minor update and add some basic code
    [baseboard.kicad_sch]
2023-04-27 Add the first preconfigured device state for testing
2023-04-28 Update fpgs code and baseboard schematic
    [baseboard.kicad_sch]
2023-04-28 Fix missing REB on the receive CLK buffer. Add comparator to the clk to convert to 3.3V logic. Change pins on the PCU to not need remapping
    [baseboard.kicad_pcb, baseboard.kicad_sch, design.kicad_pcb, design.kicad_sch]
2023-04-28 Add a ground connection for probing
    [design.kicad_pcb, design.kicad_sch]
2023-05-01 Update to different GPIO settings
    [baseboard.kicad_sch]
2023-05-01 Minor tweak - additional junction from somewhere weird
    [baseboard.kicad_sch]
2023-05-02 Add a ground test point and also update silkscreen version number
    [baseboard.kicad_pcb, baseboard.kicad_sch]
2023-05-03 Still IQ mode not working
    [max2769.c]
2023-05-03 Motherboard and radio board update
    [design.kicad_sch, motherboard.kicad_pcb, motherboard.kicad_sch]
2023-05-04 Add RPI submodule
    [motherboard.kicad_pcb, motherboard.kicad_sch]
2023-05-04 Update dev board to latest beta changes. Start working on the motherboard.
    [baseboard.kicad_pcb, baseboard.kicad_sch, motherboard.kicad_pcb, motherboard.kicad_sch, power.kicad_sch, radio_bank.kicad_sch]
2023-05-05 Update programming connector to PH2.0
    [baseboard.kicad_sch]
2023-05-05 Update footprints for comparator. Use PH2.0 for programming ;
    [baseboard.kicad_pcb, baseboard.kicad_sch]
2023-05-05 Update connector to 4 radios. Move to heirarchical design
    [design.kicad_sch, radio.kicad_sch]
2023-05-08 Update to 4 radio board in progress
    [design.kicad_sch, radio.kicad_sch]
2023-05-09 Wire up 4 radios
    [design.kicad_sch, radio.kicad_sch]
2023-05-10 Update four radios to PCB
    [design.kicad_pcb, design.kicad_sch]
2023-05-10 Layout in progress
    [design.kicad_pcb, radio.kicad_sch]
2023-05-12 First radio layout done
    [design.kicad_pcb, design.kicad_sch, radio.kicad_sch]
2023-05-12 Add mounting holes - for tie down. Further routing
    [design.kicad_pcb, design.kicad_sch]
2023-05-15 Wire up the data outputs
    [design.kicad_pcb]
2023-05-15 More layout
    [design.kicad_pcb]
2023-05-16 Add isolation cap for the comparator
    [baseboard.kicad_sch]
2023-05-17 Update to new comparator. Use new pins
    [baseboard.kicad_pcb, baseboard.kicad_sch]
2023-05-17 Radio Board Layout complete. DRC passed
    [design.kicad_pcb, motherboard.kicad_pcb, motherboard.kicad_sch, power.kicad_sch, radio_bank.kicad_sch]
2023-05-17 Add production files for radio board module
    [BOM-design.csv, design.kicad_pcb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]
2023-05-17 Group pair of 4-element radio modules into a pair
    [motherboard.kicad_pcb, motherboard.kicad_sch, radio_bank.kicad_sch]
2023-05-18 Add 3.3V supply and wire up new board
    [motherboard.kicad_pcb, motherboard.kicad_sch, power.kicad_sch]
2023-05-18 Layout nearly done. Bigger reset button
    [motherboard.kicad_pcb, motherboard.kicad_sch, radio_bank.kicad_sch]
2023-05-18 Added test points
    [motherboard.kicad_pcb, motherboard.kicad_sch, power.kicad_sch]
2023-05-18 Added production files
    [BOM-motherboard.csv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]
2023-05-31 Added new PSU to motherboard. More efficient and much cheaper.
    [motherboard.kicad_pcb, motherboard.kicad_sch, power.kicad_sch, radio_bank.kicad_sch]
2023-06-09 Update SODIMM to Standard orientation. Ref #5
    [motherboard.kicad_pcb, motherboard.kicad_sch]
2023-06-12 Add clock test board
    [clock_test.kicad_pcb, clock_test.kicad_sch]
2023-06-12 Move to new clock circuit. Subject to testing
    [motherboard.kicad_sch, power.kicad_sch]
2023-06-14 Add enable line to motherboard
    [motherboard.kicad_pcb, motherboard.kicad_sch, power.kicad_sch, radio_bank.kicad_sch]
2023-06-14 Add the shutdown line to the radio board. Fix up the DIMM footprint
    [clock_test.kicad_pcb, design.kicad_pcb, design.kicad_sch, radio.kicad_sch]
2023-06-19 Fix capacitor sizes
    [design.kicad_pcb, radio.kicad_sch]
2023-06-20 Version bump labels to v3.0.0a3
    [design.kicad_pcb]
2023-07-08 Add enable lines for the two slots. Add a + sumbol for the power supply. Issue #8
    [motherboard.kicad_pcb]
2023-07-13 Add some silkscreen stuff
    [motherboard.kicad_pcb]
2023-07-21 Create motherboard 8. Now upgrade number of radios
    [motherboard_8.kicad_pcb, motherboard_8.kicad_sch, power.kicad_sch, radio_bank.kicad_sch]
2023-07-21 Move CPU to its own board
    [mcu.kicad_sch]
2023-07-22 Start wiring things up
    [motherboard.kicad_sch, radio_bank.kicad_sch]
2023-07-23 Schematic complete. On to the PCB
    [mcu.kicad_sch, motherboard.kicad_pcb, motherboard.kicad_sch, power.kicad_sch, radio_bank.kicad_sch]
2023-07-23 Proper layout - leave only one connector fully pinned for 2-bit
    [motherboard.kicad_pcb, motherboard.kicad_sch]
2023-07-24 Rearrange the connections to be more logical
    [motherboard.kicad_pcb, motherboard.kicad_sch]
2023-07-24 Remove global label collisions for CS#. Make names more specific
    [mcu.kicad_sch, motherboard.kicad_pcb, motherboard.kicad_sch, radio_bank.kicad_sch]
2023-07-25 Add mounting holes. Route board supply, remove LED
    [mcu.kicad_sch, motherboard.kicad_pcb, motherboard.kicad_sch, power.kicad_sch, radio_bank.kicad_sch]
2023-07-25 Routing has begun in earnest
    [mcu.kicad_sch, motherboard.kicad_pcb, motherboard.kicad_sch]
2023-07-27 Add holes for a spelsberg
    [mcu.kicad_sch, motherboard.kicad_pcb, radio_bank.kicad_sch]
2023-07-27 Update routing
    [motherboard.kicad_pcb, power.kicad_sch]
2023-07-27 More routing
    [mcu.kicad_sch, motherboard.kicad_pcb, motherboard.kicad_sch]
2023-07-29 Added box footprint
2023-07-29 Update footprint for box layout
    [motherboard.kicad_sch, power.kicad_sch]
2023-07-30 Version 3.0.0b1
    [motherboard.kicad_sch, power.kicad_sch]
2023-07-31 Update to use edge mountyed SMA
    [design.kicad_pcb, design.kicad_sch, mcu.kicad_sch, radio.kicad_sch]
2023-09-10 Now have a decent throbbing LED
2023-09-17 Nicer flashing LED
2023-09-19 Update the label for M6 -> P8 on IOR42B. Was an error in the footprint from Sipeed
    [motherboard.kicad_sch]
2023-10-20 Removed old files
    [BOM-design.csv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]
2023-11-01 Update holes to m4
2024-03-29 Add a notebook on how I made the pulsing LED
2024-03-29 Added a driver to the receive side of the clock
    [design.kicad_sch, mcu.kicad_sch, motherboard.kicad_sch, power.kicad_sch, radio.kicad_sch, radio_bank.kicad_sch]
2024-03-30 Add a clock distribution buffer to the radio board. See Issue #10
    [design.kicad_pcb, design.kicad_sch, radio.kicad_sch]
2024-03-30 Added proper clock test
    [clock_test.kicad_pcb, clock_test.kicad_sch]
2024-03-31 Add a pair of termination resistors on each clock line
    [clock_test.kicad_pcb, clock_test.kicad_sch]
2024-04-02 Update motherboard to k8
    [connector.kicad_sch, mcu.kicad_sch, motherboard.kicad_sch, power.kicad_sch, radio_bank.kicad_sch]
2024-04-13 First add of interposer
    [connector.kicad_sch, papilio_sodimm_interposer.kicad_pcb, papilio_sodimm_interposer.kicad_sch, spartan-6_papilio_sodimm.ods]
2024-04-14 Got it going
    [connector.kicad_sch, papilio_sodimm_interposer.kicad_sch]
2024-04-15 Update interposer and clock test
    [clock_test.kicad_pcb, clock_test.kicad_sch, papilio_sodimm_interposer.kicad_sch]
2024-04-15 Added nice footprints for correlator
2024-04-15 Added Edge Connector
2024-05-03 Added proper library for Correlator socket, and a proper components too. New interposer board
    [correlator_to_papilio.kicad_pcb, correlator_to_papilio.kicad_sch, motherboard_8.kicad_sch, power.kicad_sch, radio_bank.kicad_sch]
2024-05-06 Update the footprints and layout
    [correlator_to_papilio.kicad_pcb, correlator_to_papilio.kicad_sch, papilio_sodimm_interposer.kicad_sch]
2024-05-15 Fix radio 4, and radio 7 being on the wrong pins
    [correlator_to_papilio.kicad_pcb, correlator_to_papilio.kicad_sch, mcu.kicad_sch, motherboard.kicad_sch, power.kicad_sch, radio_bank.kicad_sch]
2024-05-15 Added a basic correlator
    [correlator.kicad_sch, psu.kicad_sch, spartan6.kicad_sch, spartan6_correlator.kicad_pcb, spartan6_correlator.kicad_sch]
2024-05-16 Updated to version c
    [correlator_to_papilio.kicad_pcb, correlator_to_papilio.kicad_sch, design.kicad_pcb, design.kicad_sch]
2024-07-10 Getting 3.0.0b3 ready
    [connector.kicad_sch, mcu.kicad_sch, motherboard.kicad_pcb, motherboard.kicad_sch, power.kicad_sch, radio_bank.kicad_sch]
2024-07-29 Update to get rid of horrible duplicate symbols
    [mcu.kicad_sch, motherboard.kicad_pcb, motherboard.kicad_sch, power.kicad_sch, radio_bank.kicad_sch]
2024-07-31 Enlarge holes
    [mcu.kicad_sch, motherboard.kicad_pcb, motherboard.kicad_sch, power.kicad_sch, radio_bank.kicad_sch]
