tart-telescope/radio_module/(notices)

Notices in the files:
hardware/dev_board/baseboard.kicad_sch:
Licensed Under GPL v3
hardware/correlator_to_papilio/correlator_to_papilio.kicad_sch:
Copyright (c) Tim Molteno 2024
hardware/motherboard_8/motherboard_8.kicad_pcb:
GPL v3.0, June 2023
hardware/papilio_sodimm_interposer/papilio_sodimm_interposer.kicad_pcb:
©2024
hardware/papilio_sodimm_interposer/papilio_sodimm_interposer.kicad_sch:
©Phill Brown 2024, Gadget Factory 2009-2012
This work is licenced under the GPL v3 or later.
hardware/motherboard/motherboard.kicad_pcb:
GPL v3.0, July 2024
